DudeYarvie/JARViE_Battery_Saver_Board/src/Examples/PR_TFT_Mobile_Phone_Demo/images/android_home.jpg

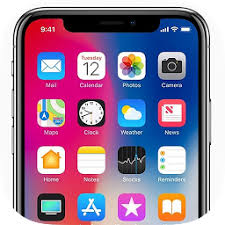
src/Examples/PR_TFT_Mobile_Phone_Demo/images/android_home.jpg
