DudeYarvie/JARViE_Battery_Saver_Board/src/Examples/PR_TFT_Mobile_Phone_Demo/images/BigOreo.bmp

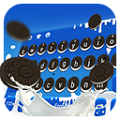
src/Examples/PR_TFT_Mobile_Phone_Demo/images/BigOreo.bmp
