DudeYarvie/JARViE_Battery_Saver_Board/src/Examples/PR_TFT_Mobile_Phone_Demo/images/ios_home2.png

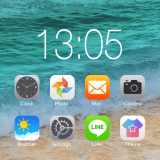
src/Examples/PR_TFT_Mobile_Phone_Demo/images/ios_home2.png
