DudeYarvie/JARViE_Battery_Saver_Board/Reference Docs/SCH, 10131985_MOSFET_Driver_RevC.pdf

A

A

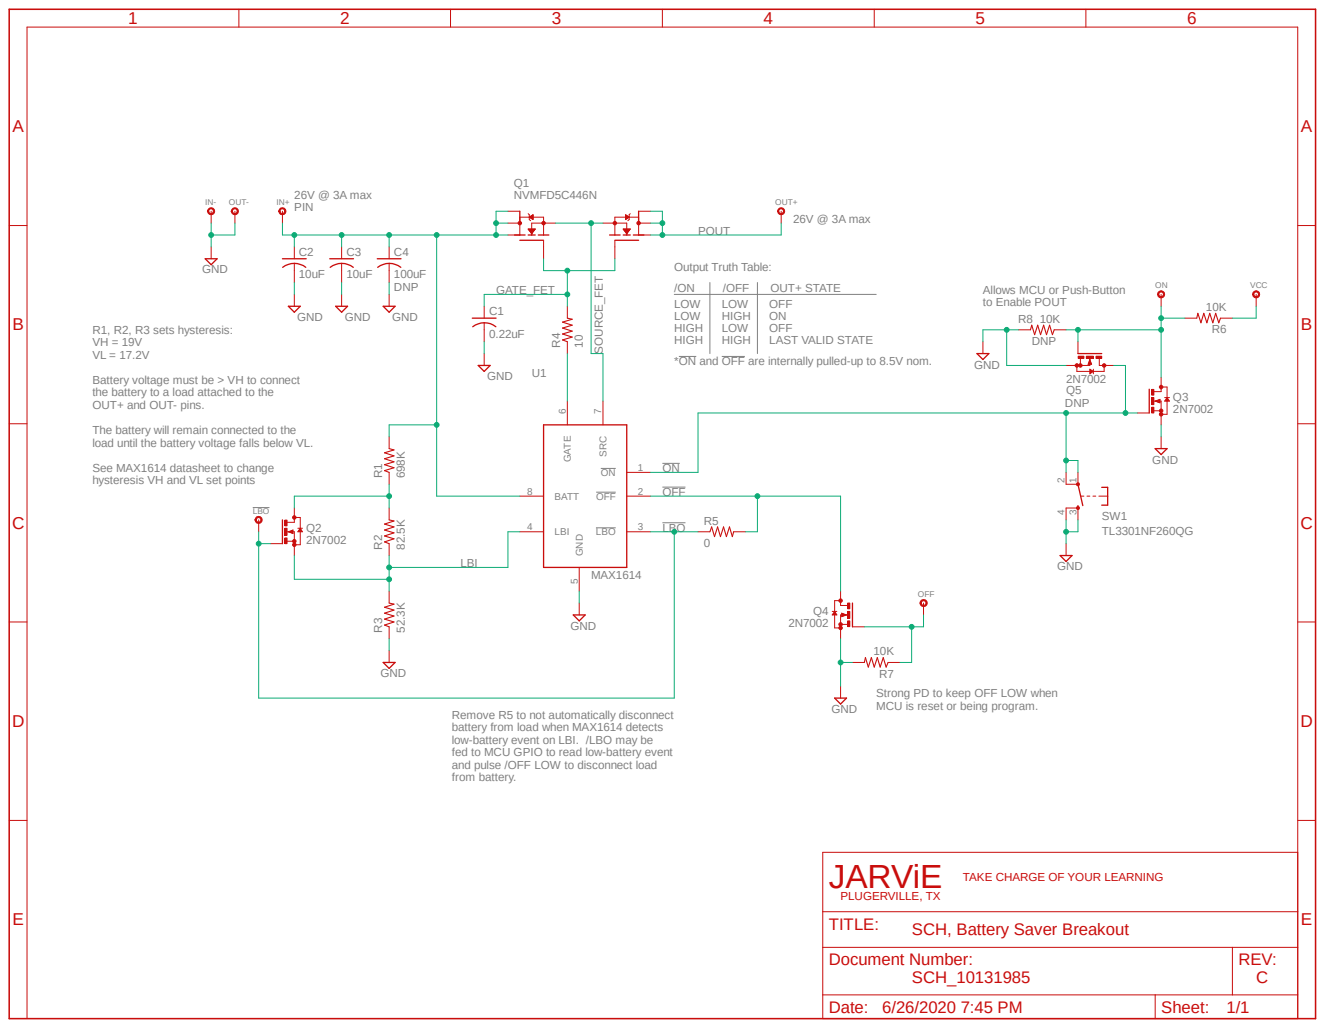
[picture p9: page 1]

Allows MCU or Push-Button
to Enable POUT

*ON and OFF are internally pulled-up to 8.5V nom.

Battery voltage must be > VH to connect
the battery to a load attached to the
OUT+ and OUT- pins.

The battery will remain connected to the
load until the battery voltage falls below VL.

See MAX1614 datasheet to change
hysteresis VH and VL set points

Strong PD to keep OFF LOW when
MCU is reset or being program.

Remove R5 to not automatically disconnect
battery from load when MAX1614 detects
low-battery event on LBI. /LBO may be
fed to MCU GPIO to read low-battery event
and pulse /OFF LOW to disconnect load
from battery.

TAKE CHARGE OF YOUR LEARNING

SCH, Battery Saver Breakout

Document Number: SCH_10131985 | REV: C

Date: 6/26/2020 7:45 PM | Sheet: 1/1
