DudeYarvie/JARViE_Battery_Saver_Board/Reference Docs/Pics/Example_Setup.jpg

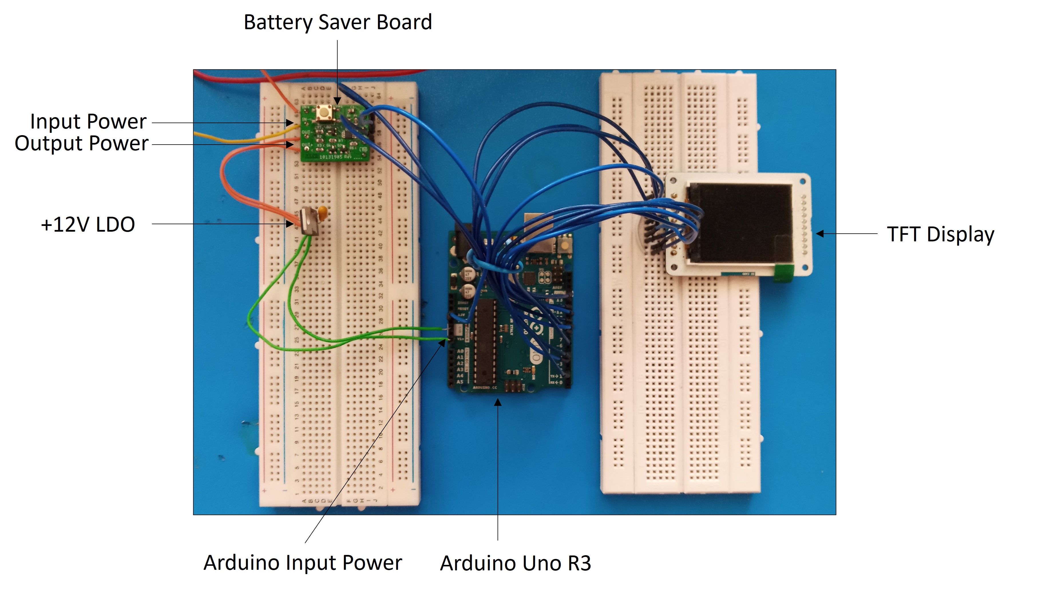
Reference Docs/Pics/Example_Setup.jpg
